3-SAT/hwcron/HwCron_prototype/hwcron_prototype.pdf

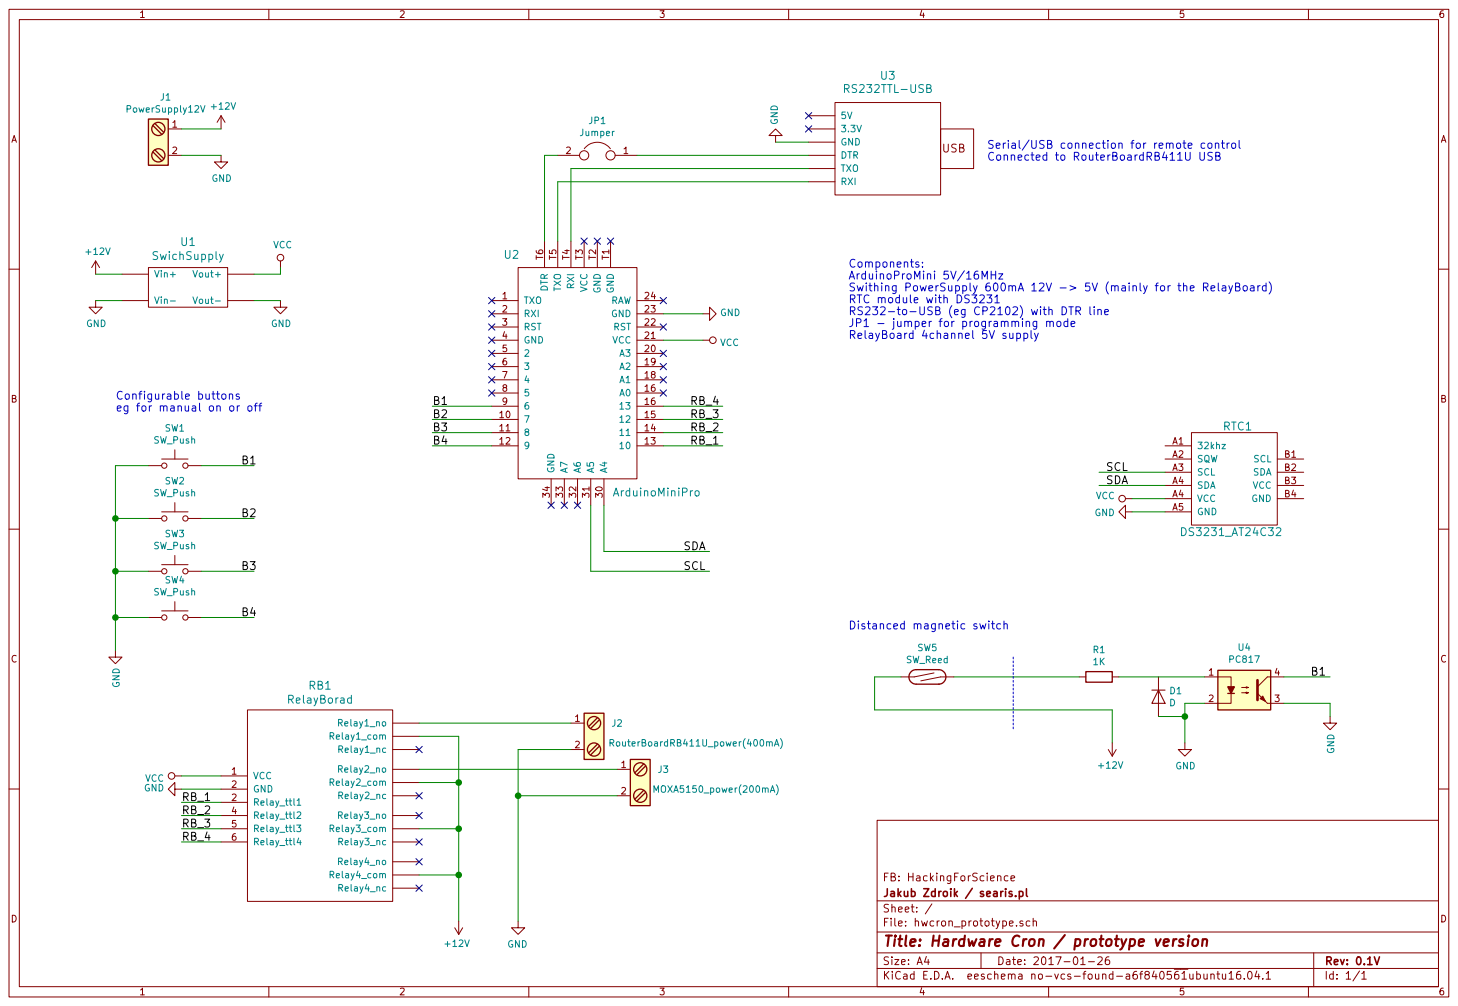
[picture p2: page 1]

Serial/USB connection for remote control
Connected to RouterBoardRB411U USB

Components:
ArduinoProMini 5V/16MHz
Swithing PowerSupply 600mA 12V -> 5V (mainly for the RelayBoard)
RTC module with DS3231
RS232-to-USB (eg CP2102) with DTR line
JP1 - jumper for programming mode
RelayBoard 4channel 5V supply

Configurable buttons
eg for manual on or off

FB: HackingForScience
File: hwcron_prototype.sch Sheet: / Jakub Zdroik / searis.pl

Id: 1/1 Title: Hardware Cron / prototype version
