3-SAT/hwcron/HwCron_prototype/hwcron_prototype.sch

## KiCad design HwCron_prototype/hwcron_prototype.sch (2017-10-29)

Schematic: hwcron_prototype.sch

Parts:
D1: D
J1: PowerSupply12V
J2: RouterBoardRB411U_power(400mA)
J3: MOXA5150_power(200mA)
JP1: Jumper
R1: 1K
RB1: RelayBorad
RTC1: DS3231_AT24C32
SW1, SW2, SW3, SW4: SW_Push
SW5: SW_Reed
U1: SwichSupply
U2: ArduinoMiniPro
U3: RS232TTL-USB
U4: PC817; DIP-4_W7.62mm

Notes on the sheet:
Components: ArduinoProMini 5V/16MHz Swithing PowerSupply 600mA 12V -> 5V (mainly for the RelayBoard) RTC module with DS3231 RS232-to-USB (eg CP2102) with DTR line JP1 - jumper for programming mode RelayBoard 4channel 5V supply
Configurable buttons eg for manual on or off
Serial/USB connection for remote control Connected to RouterBoardRB411U USB
Distanced magnetic switch
