3-SAT/hwcron/(commit log)

2017-01-22 conversion from alarm state to pin state
2017-01-25 alarm_timeout to pin_timeout, buttons for manual pin on
2017-01-27 Documentation and readme
    [hwcron_prototype.sch]
2017-10-29 Add long distanced reed switch for wakeup
    [hwcron_prototype.sch]
2017-11-19 Added analog power control v!
